CJA1701/NX-01-Nixie-Watch/README.md

Nixie tube based watch I designed in 2024. For more info see the pdf presentation.
