CJA1701/NX-01-Nixie-Watch/NX-01 Watch Design V6.0.stl

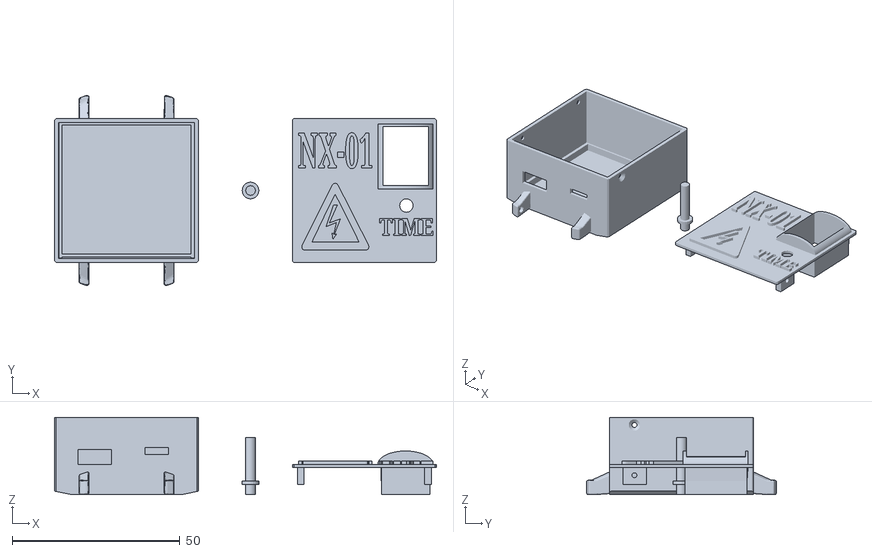
[picture p11: CAD file, 2024-05-04]
NX-01 Watch Design V6.0.stl
114.0 x 56.6 x 23.0
