CJA1701/NX-01-Nixie-Watch/Nixie Watch Single Tube Concept-Nixie Watch Single Tube ConceptPcb_13cf.stl

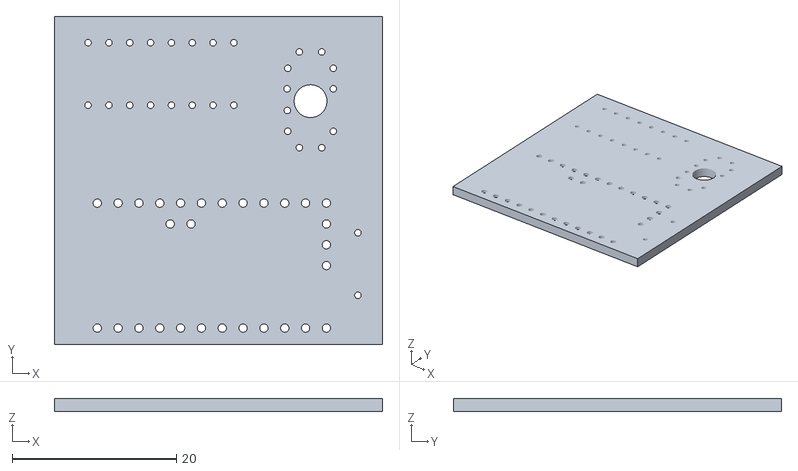
[picture p12: CAD file, 2024-04-28]
Nixie Watch Single Tube Concept-Nixie Watch Single Tube ConceptPcb_13cf.stl
40.0 x 40.0 x 1.60
