CJA1701/NX-01-Nixie-Watch/Nixie Watch Single Tube Concept.kicad_pcb

## KiCad design Nixie Watch Single Tube Concept.kicad_pcb (2024-04-28)

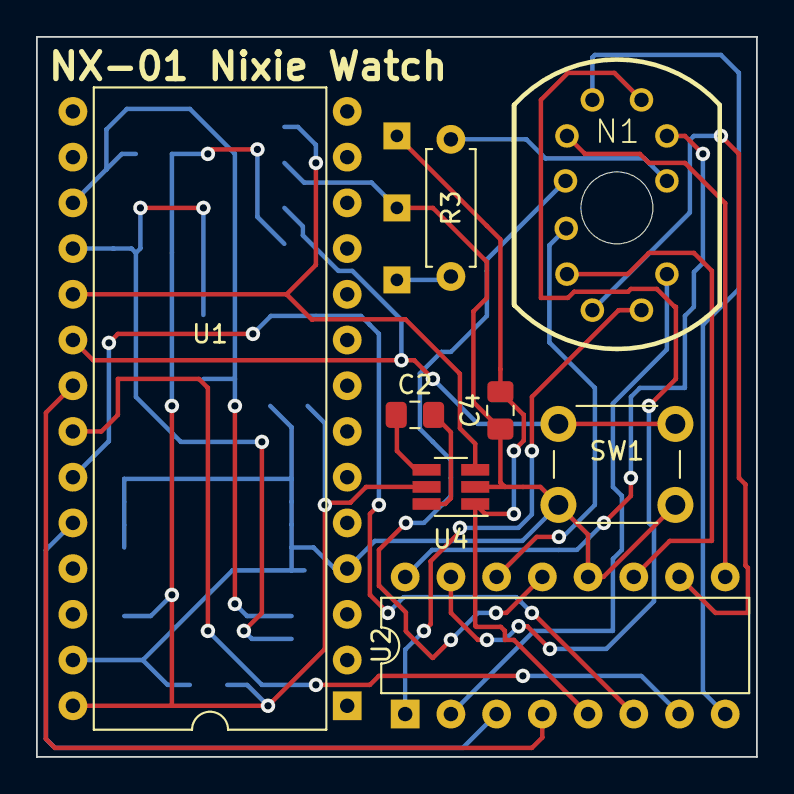
[picture p13: board Nixie Watch Single Tube Concept.kicad_pcb from above]

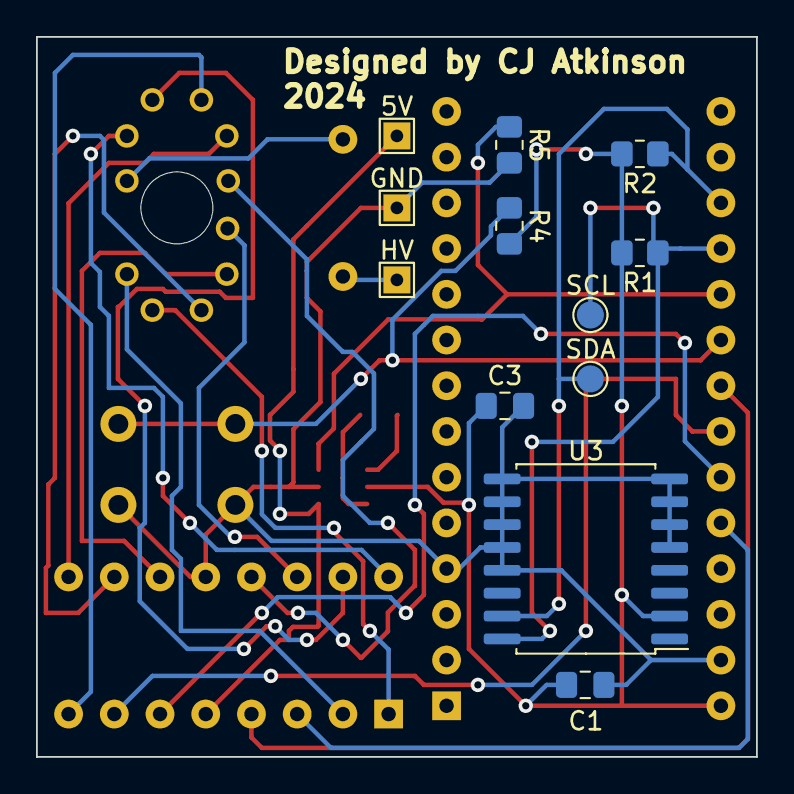
[picture p14: board Nixie Watch Single Tube Concept.kicad_pcb from below]

Board: 2 copper layers, 40.0 x 40.0 mm, 20 parts (12 on the bottom side), 25 nets.

Parts:
5V: 5V; TestPoint_THTPad_1.5x1.5mm_Drill0.7mm
C1: 0.1-1uF; C_0805_2012Metric_Pad1.18x1.45mm_HandSolder
C2: 1uF; C_0805_2012Metric_Pad1.18x1.45mm_HandSolder
C3, C4: 10uF; C_0805_2012Metric_Pad1.18x1.45mm_HandSolder
GND: GND; TestPoint_THTPad_1.5x1.5mm_Drill0.7mm
HV: HV; TestPoint_THTPad_1.5x1.5mm_Drill0.7mm
N1: IN-17; nixies-us-IN-17
R1, R2: 4.3K; R_0805_2012Metric_Pad1.20x1.40mm_HandSolder
R3: 39K 1/4W; R_Axial_DIN0207_L6.3mm_D2.5mm_P7.62mm_Horizontal
R4: 1K; R_0805_2012Metric_Pad1.20x1.40mm_HandSolder
R5: 100K; R_0805_2012Metric_Pad1.20x1.40mm_HandSolder
SCL: Conn_01x01_Pin; TestPoint_Pad_D1.5mm
SDA: Conn_01x01_Pin; TestPoint_Pad_D1.5mm
SW1: SW_Push; SW_PUSH_6mm_H4.3mm
U1: DIP-28_W15.24mm
U2: 74141; DIP-16_W7.62mm
U3: DS3231M; SOIC-16W_7.5x10.3mm_P1.27mm
U4: AP3602A; SOT-23-6_Handsoldering

Connections:
+BATT: C1.1, C3.1, R1.2, R2.2, R4.2, U1.28 (VBAT), U3.2 (VCC), U4.5 (VIN)
GND: C1.2, C3.2, C4.1, GND.1, R5.2, SW1.2, U1.4 (GND), U1.27 (GND), U2.12 (GND), U3.5 (GND), U3.6 (GND), U3.7 (GND), U3.8 (GND), U3.9 (GND), U3.10 (GND), U3.11 (GND), U3.12 (GND), U3.13 (GND), U4.2 (GND)
unnamed: 5V.1, C4.2, U2.5 (VCC), U4.1 (5VO)
unnamed: HV.1, R3.1
unnamed: N1.A, R3.2
unnamed: R1.1, SCL.1, U1.18 (SCL), U3.16 (SCL)
unnamed: R2.1, SDA.1, U1.17 (SDA), U3.15 (SDA)
unnamed: R5.1, U1.19 (D5), U4.3 (SHDN)
unnamed: R4.1, SW1.1, U1.20 (D7)
unnamed: U1.21 (D9), U2.4 (D)
unnamed: U1.22 (D10), U2.7 (C)
unnamed: U1.23 (D11), U2.6 (B)
unnamed: U1.24 (D12), U2.3 (A)
unnamed: N1.0, U2.16 (0)
unnamed: N1.1, U2.15 (1)
unnamed: N1.2, U2.8 (2)
unnamed: N1.3, U2.9 (3)
unnamed: N1.4, U2.13 (4)
unnamed: N1.5, U2.14 (5)
unnamed: N1.6, U2.11 (6)
unnamed: N1.7, U2.10 (7)
unnamed: N1.8, U2.1 (8)
unnamed: N1.9, U2.2 (9)
unnamed: C2.2, U4.6 (C+)
unnamed: C2.1, U4.4 (C-)
