CJA1701/NX-01-Nixie-Watch/(commit log)

2024-04-28 PCB Files and Schematic
    [Nixie Watch Single Tube Concept-Nixie Watch Single Tube ConceptPcb_13cf.stl, Nixie Watch Single Tube Concept.kicad_pcb, Nixie Watch Single Tube Concept.kicad_sch]
2024-04-28 Case Design V6.0
    [NX-01 Case V6.0.stl]
